FenderPlymouth/Muon_Detector/Data/48%.jpg

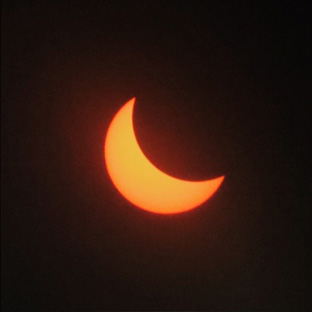
Data/48%.jpg
