FenderPlymouth/Muon_Detector/Data/0%.jpg

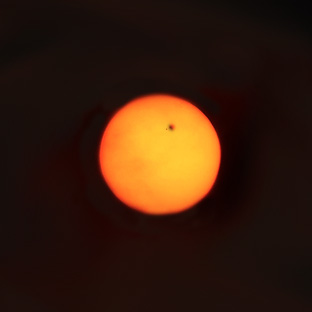
Data/0%.jpg
