FenderPlymouth/Muon_Detector/Data/98%.jpg

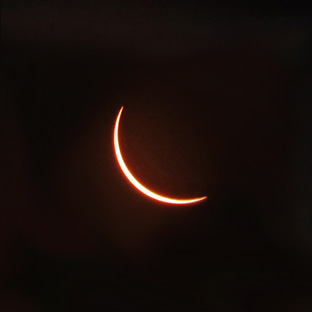
Data/98%.jpg
