FenderPlymouth/Muon_Detector/Data/100%.jpg

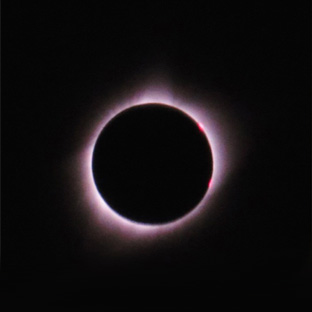
Data/100%.jpg
